HarrysLapTimer/WeatherStationOne/sketches/weatherbase/data/BolbroHaus.png

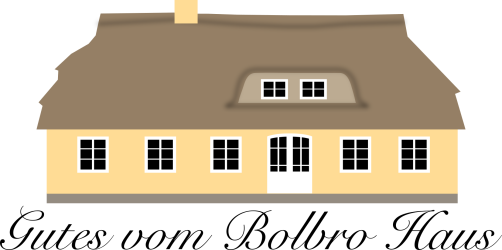
sketches/weatherbase/data/BolbroHaus.png
