HarrysLapTimer/WeatherStationOne/CircuitSensorsAS5600.pdf

# Weather Station One

# Harald Schlangmann, February 2022

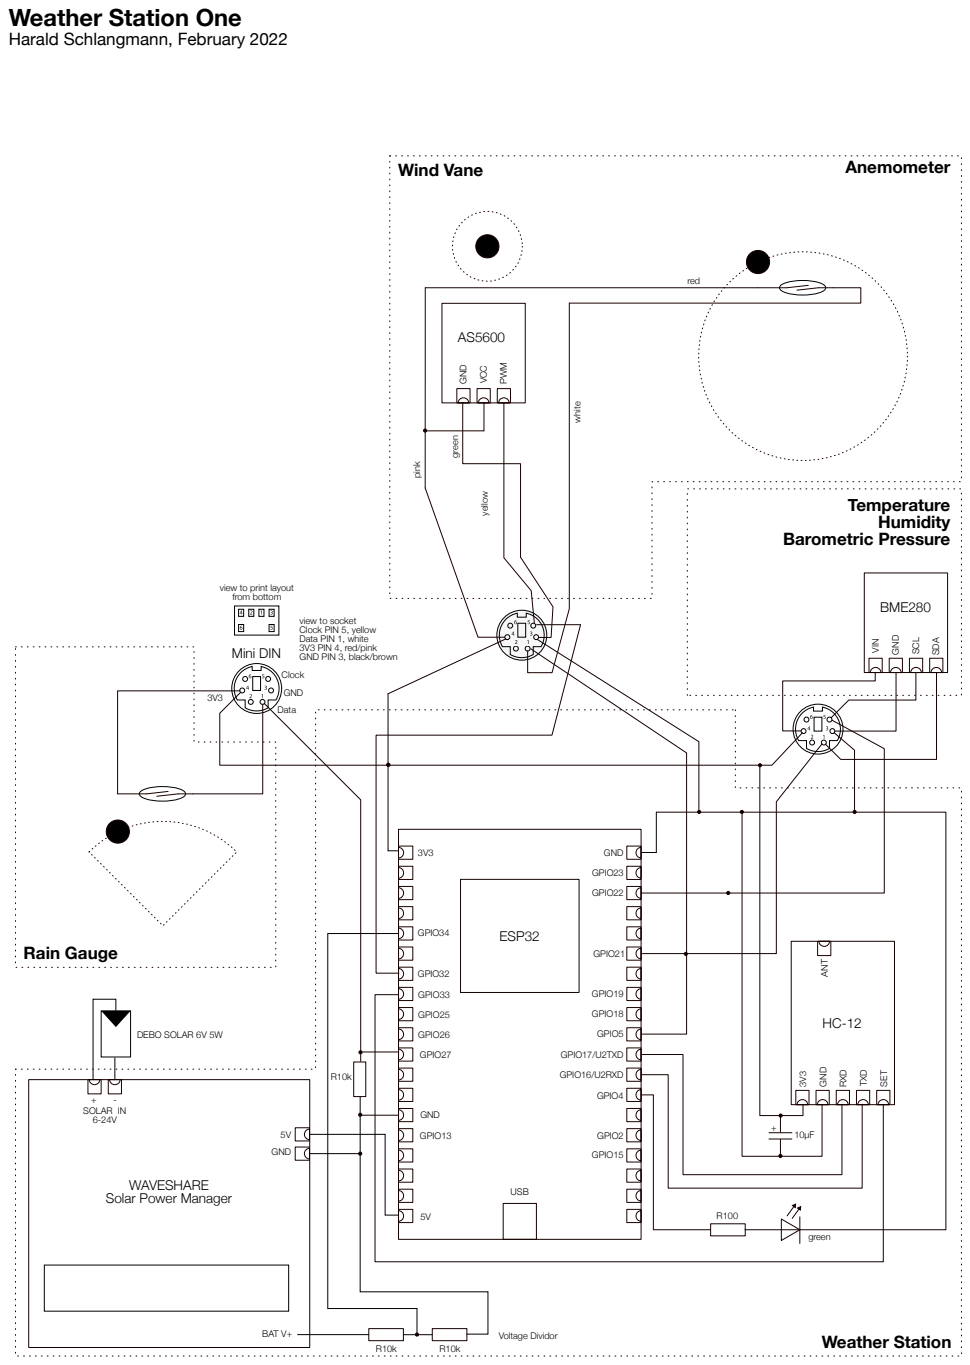
[picture p4: page 1]
GPIO15; GPIO18; GPIO2; GPIO5; GND; GPIO32; USB; ESP32; Weather Station; RXD; TXD; SET; ANT; GPIO17/U2TXD; GPIO16/U2RXD; GPIO33; GPIO21; GPIO22; GPIO27; GPIO4; SOLAR IN 6-24V; BAT V+; GPIO34; Voltage Dividor; green; DEBO SOLAR 6V 5W; GPIO25; GPIO26; GPIO13; GPIO23; GPIO19; Wind Vane; Anemometer; red; yellow; pink; white; VCC; PWM; Rain Gauge; Mini DIN; Data; VIN; SCL; SDA; BME280; Temperature Humidity Barometric Pressure

view to print layout
from bottom

view to socket
Clock PIN 5, yellow
Data PIN 1, white
3V3 PIN 4, red/pink
GND PIN 3, black/brown
Clock

WAVESHARE
Solar Power Manager
