HarrysLapTimer/WeatherStationOne/CircuitSolarTracker.pdf

# Weather Station One

# Harald Schlangmann, April 2021

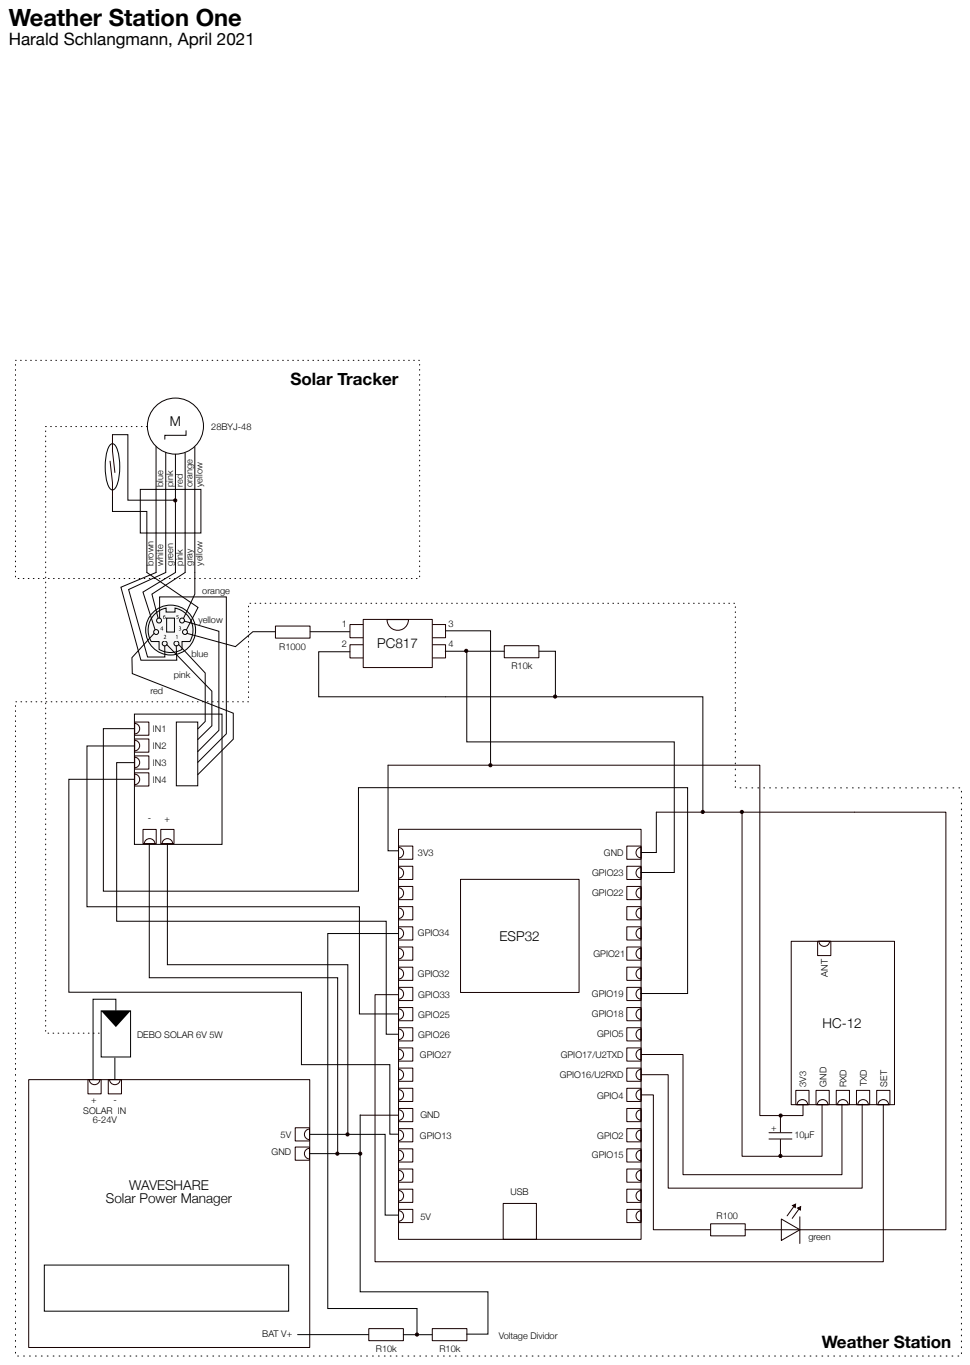
[picture p5: page 1]
GPIO15; GPIO18; GPIO2; GPIO5; GND; GPIO32; USB; ESP32; Weather Station; RXD; TXD; SET; ANT; GPIO17/U2TXD; GPIO16/U2RXD; GPIO33; GPIO21; GPIO22; GPIO27; GPIO4; SOLAR IN 6-24V; BAT V+; GPIO34; Voltage Dividor; green; DEBO SOLAR 6V 5W; GPIO25; GPIO26; GPIO13; GPIO23; GPIO19; 28BYJ-48; blue pink red; orange yellow; brown white; green pink; gray; yellow; blue; pink; orange; Solar Tracker; red

WAVESHARE
Solar Power Manager
