HarrysLapTimer/WeatherStationOne/(commit log)

2021-04-04 added calibration, further fixes
    [weatherstation.ino]
2021-04-05 admin interface, height correction, others
    [weatherstation.ino]
2021-04-22 support for wind speed units, handle error conditions
    [weatherstation.ino]
2021-05-03 preps for solar tracker, fixed rain gauge
    [Tracker.h, weatherstation.ino]
2021-12-08 adjusted battery percentage calculation
2021-12-27 software work around for horizontal rain bucket added
